tsshendo/PFC-Implementation--Senior-Design-Project/Schematic PDF.pdf

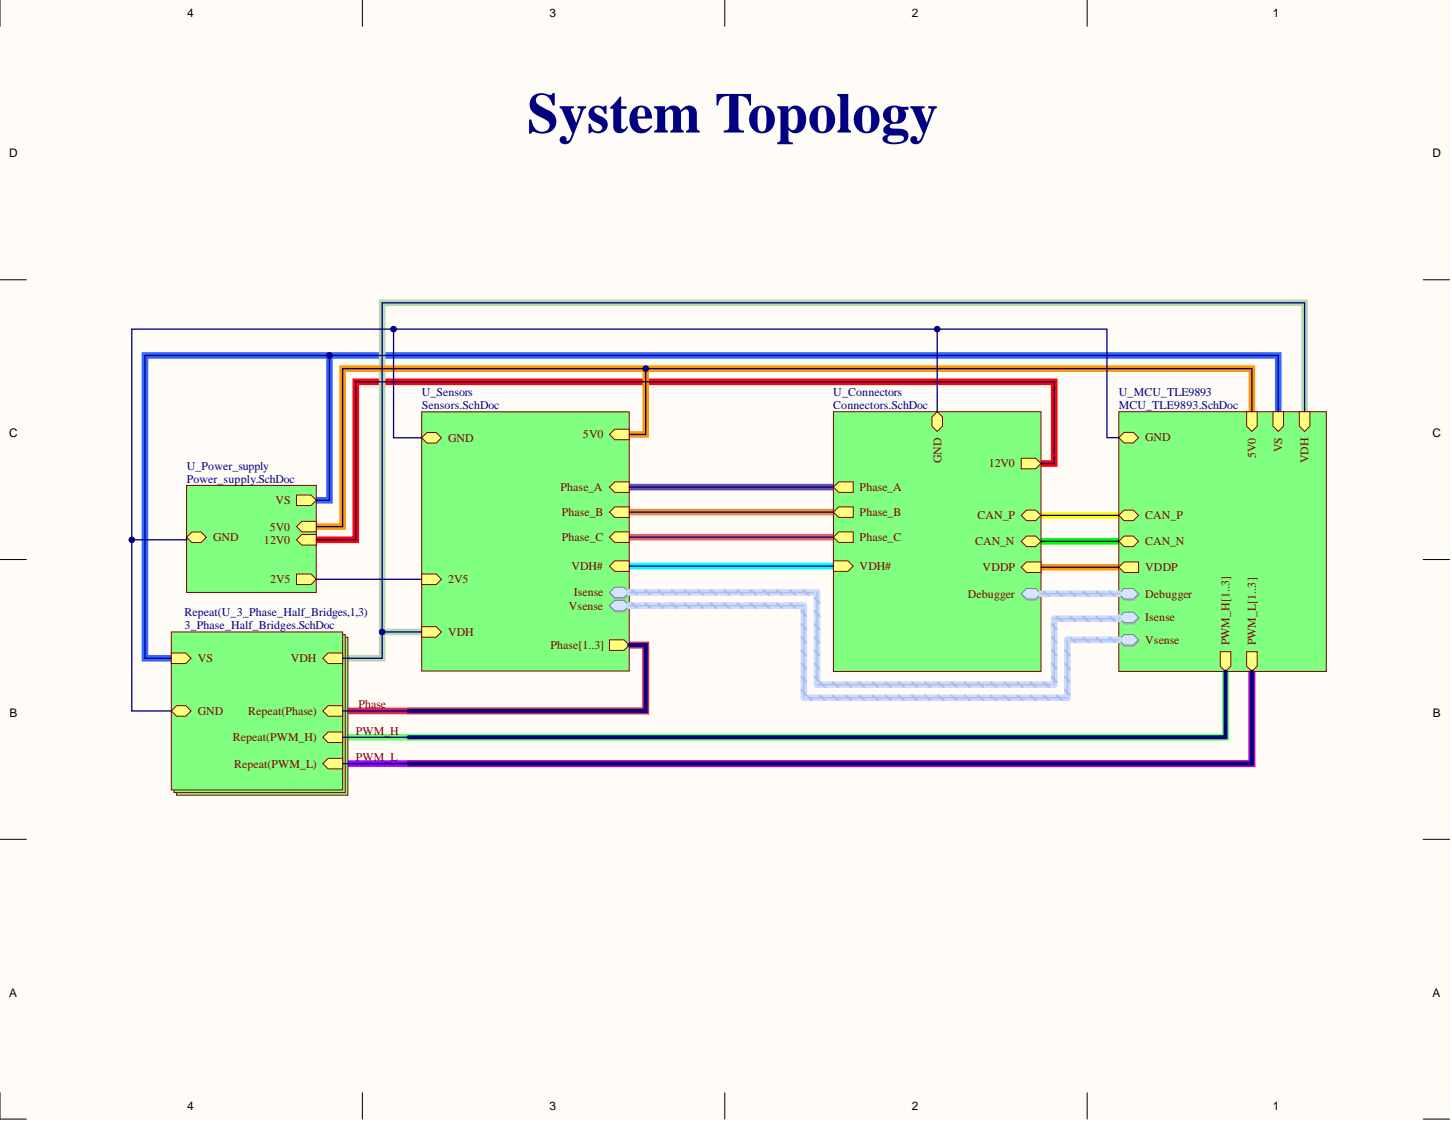
[picture p1: page 1]
System Topology

U_Sensors Sensors.SchDoc | U_Connectors Connectors.SchDoc

U_MCU_TLE9893 MCU_TLE9893.SchDoc

5V0 GND Phase_A | 12V0 Phase_A | | | GND VS

Phase_B Phase_C VDH# 2V5 Isense Vsense VDH | | Phase_B CAN_P Phase_C CAN_N VDH# VDDP Debugger | CAN_P CAN_N VDDP Debugger Isense

Phase[1..3] | | Vsense

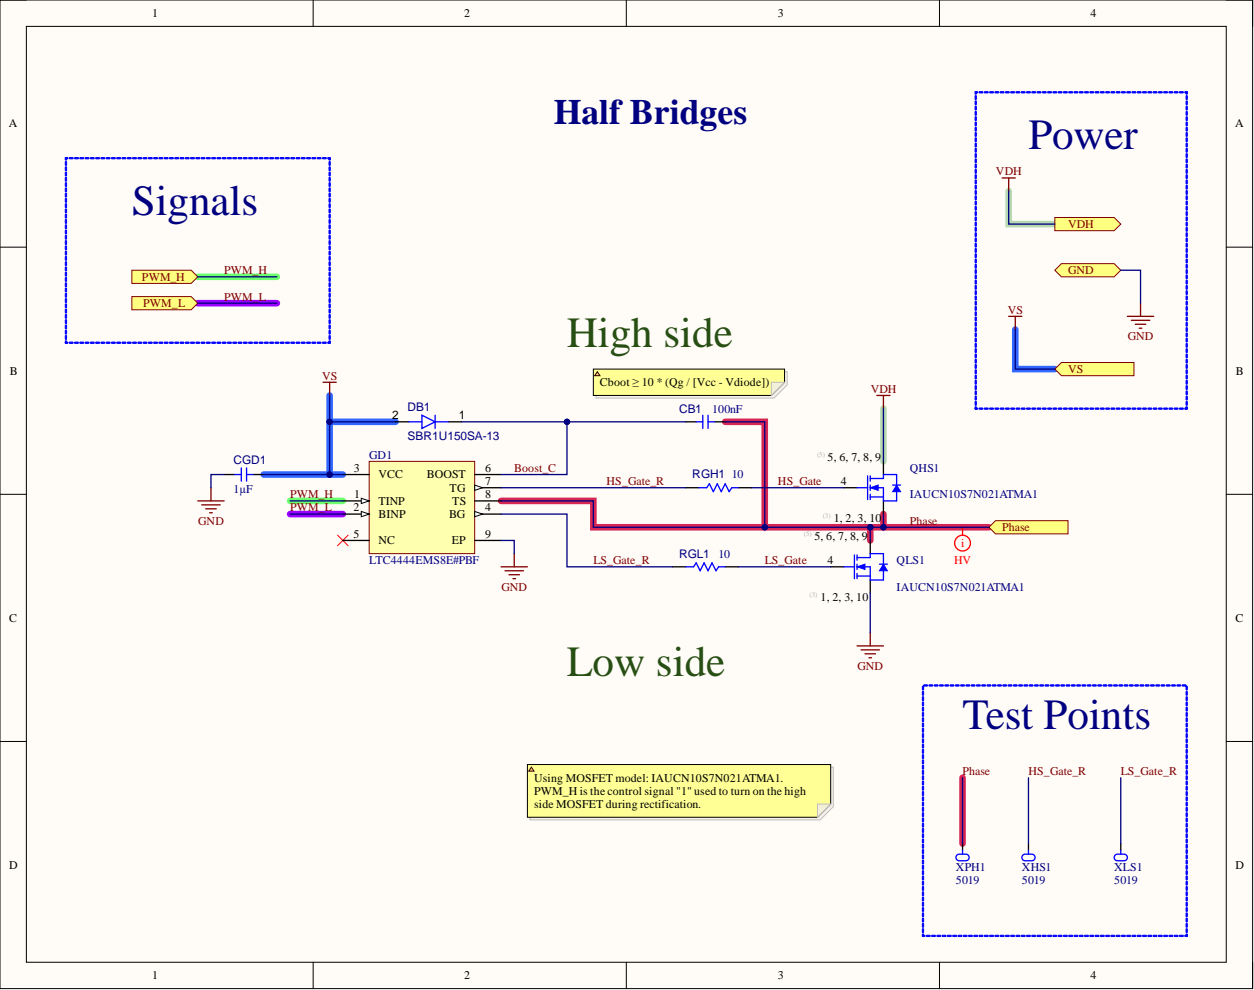
[picture p2: page 2]
Half Bridges; High side; Low side; Test Points; TINP 1 BINP 2; VCC 3; RGL1 10

Cboot ≥ 10 * (Qg / [Vcc - Vdiode])

Using MOSFET model: IAUCN10S7N021ATMA1.
PWM_H is the control signal "1" used to turn on the high
side MOSFET during rectification.

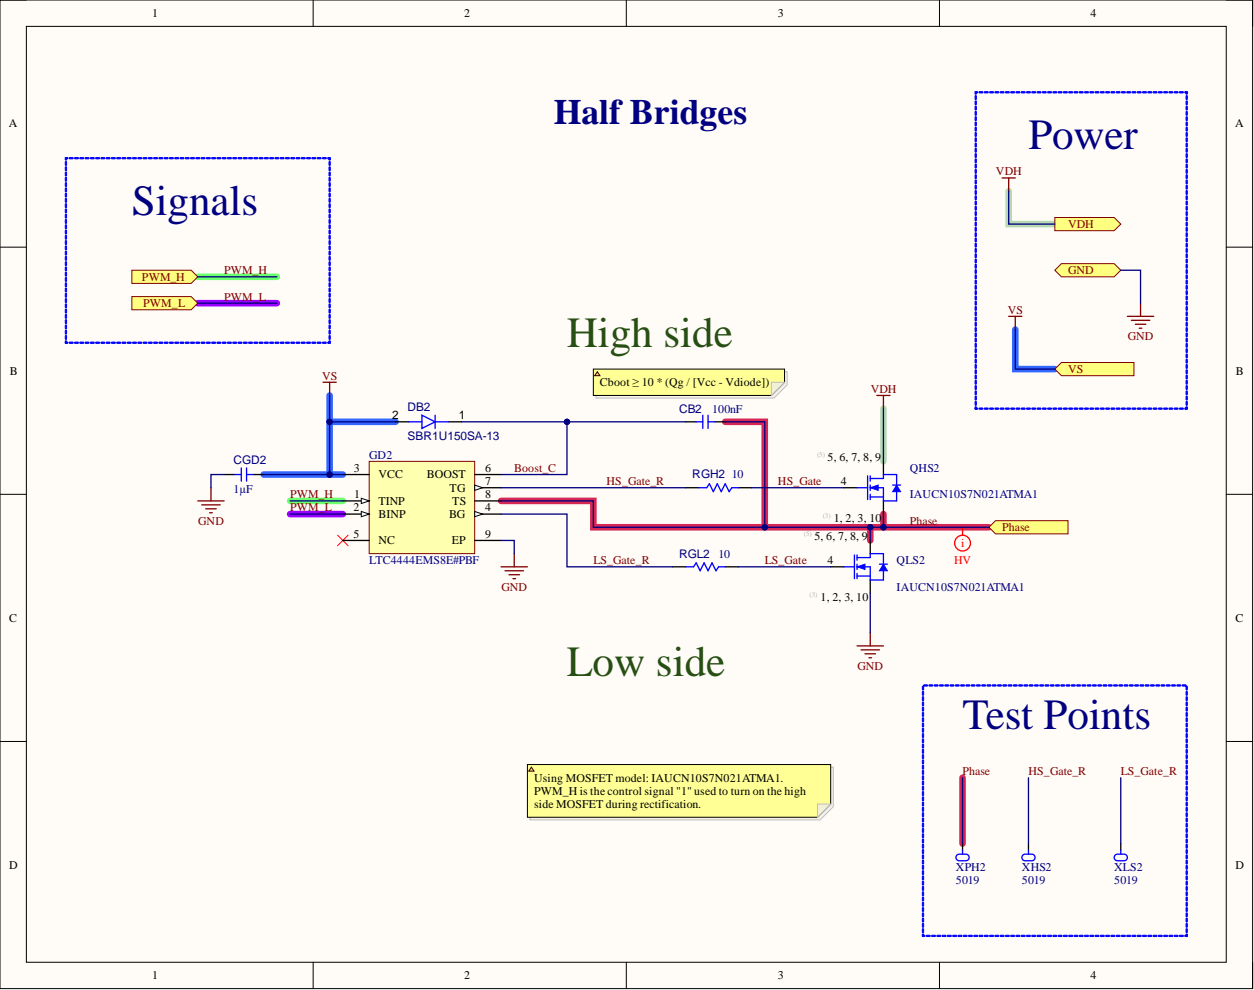
[picture p3: page 3]
Half Bridges; High side; Low side; Test Points; TINP 1 BINP 2; VCC 3; RGL2 10

Cboot ≥ 10 * (Qg / [Vcc - Vdiode])

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

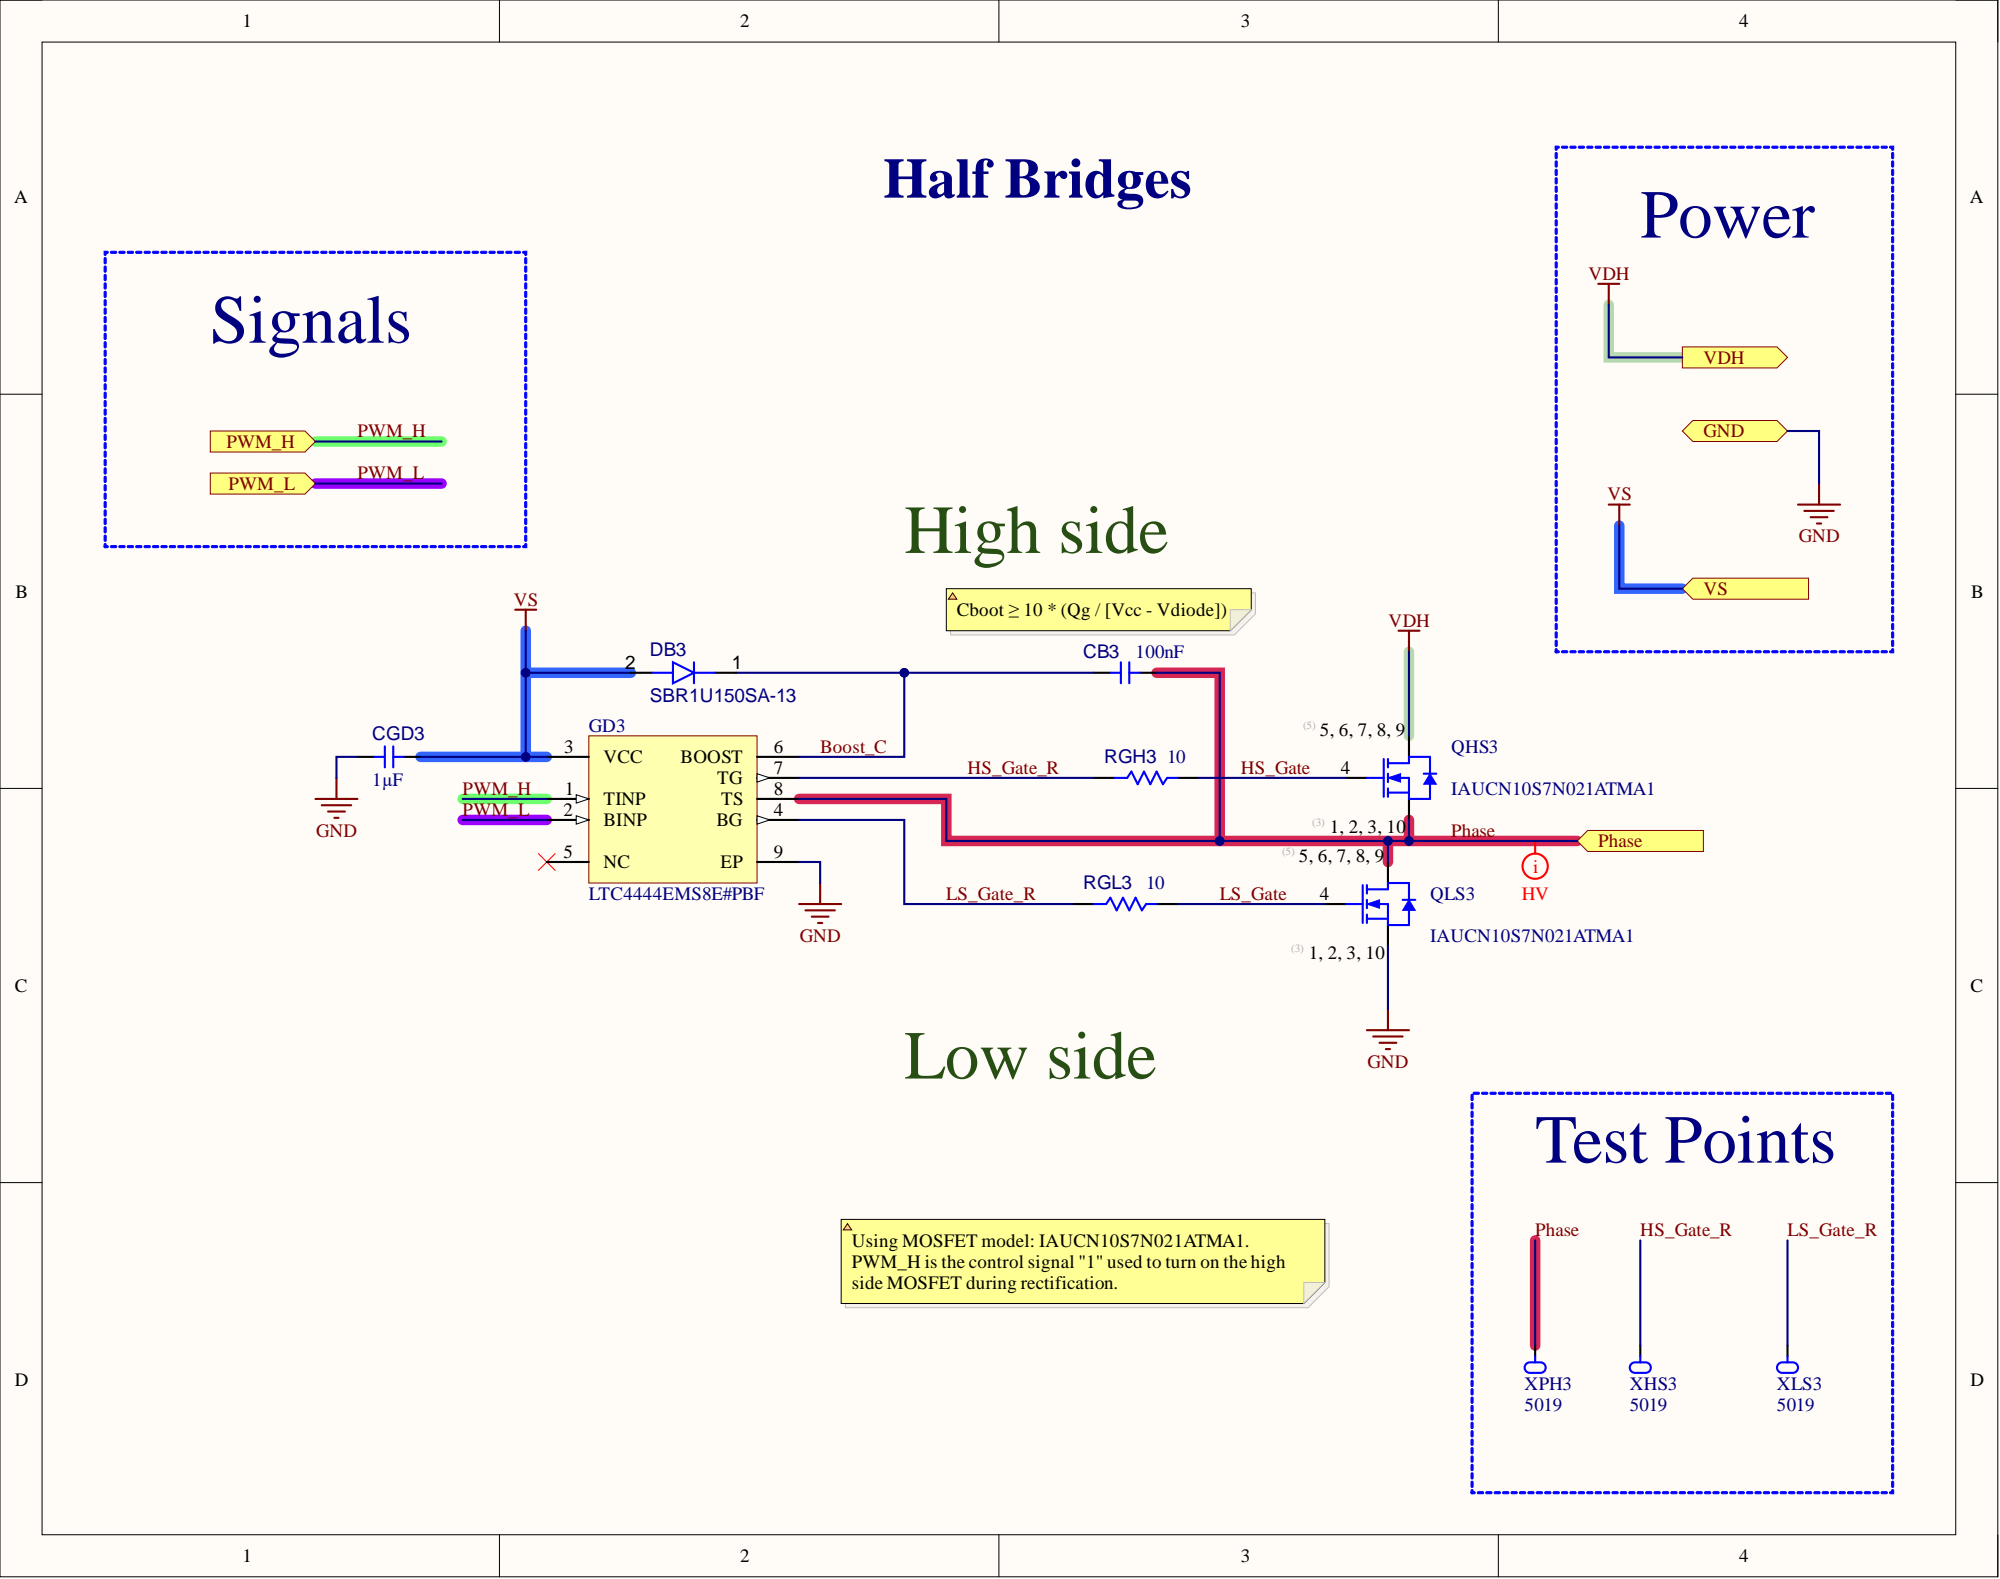
[picture p4: page 4]
Half Bridges; High side; Low side; Test Points; TINP 1 BINP 2; VCC 3; RGL3 10; PIGD306; NLBoost0C PICGD301; PIRGH302; PIQHS304 NLHS0Gate PIGD307; PIRGH301; NLPWM0H POPWM0H; NLPWM0L POPWM0L

Cboot ≥ 10 * (Qg / [Vcc - Vdiode])

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

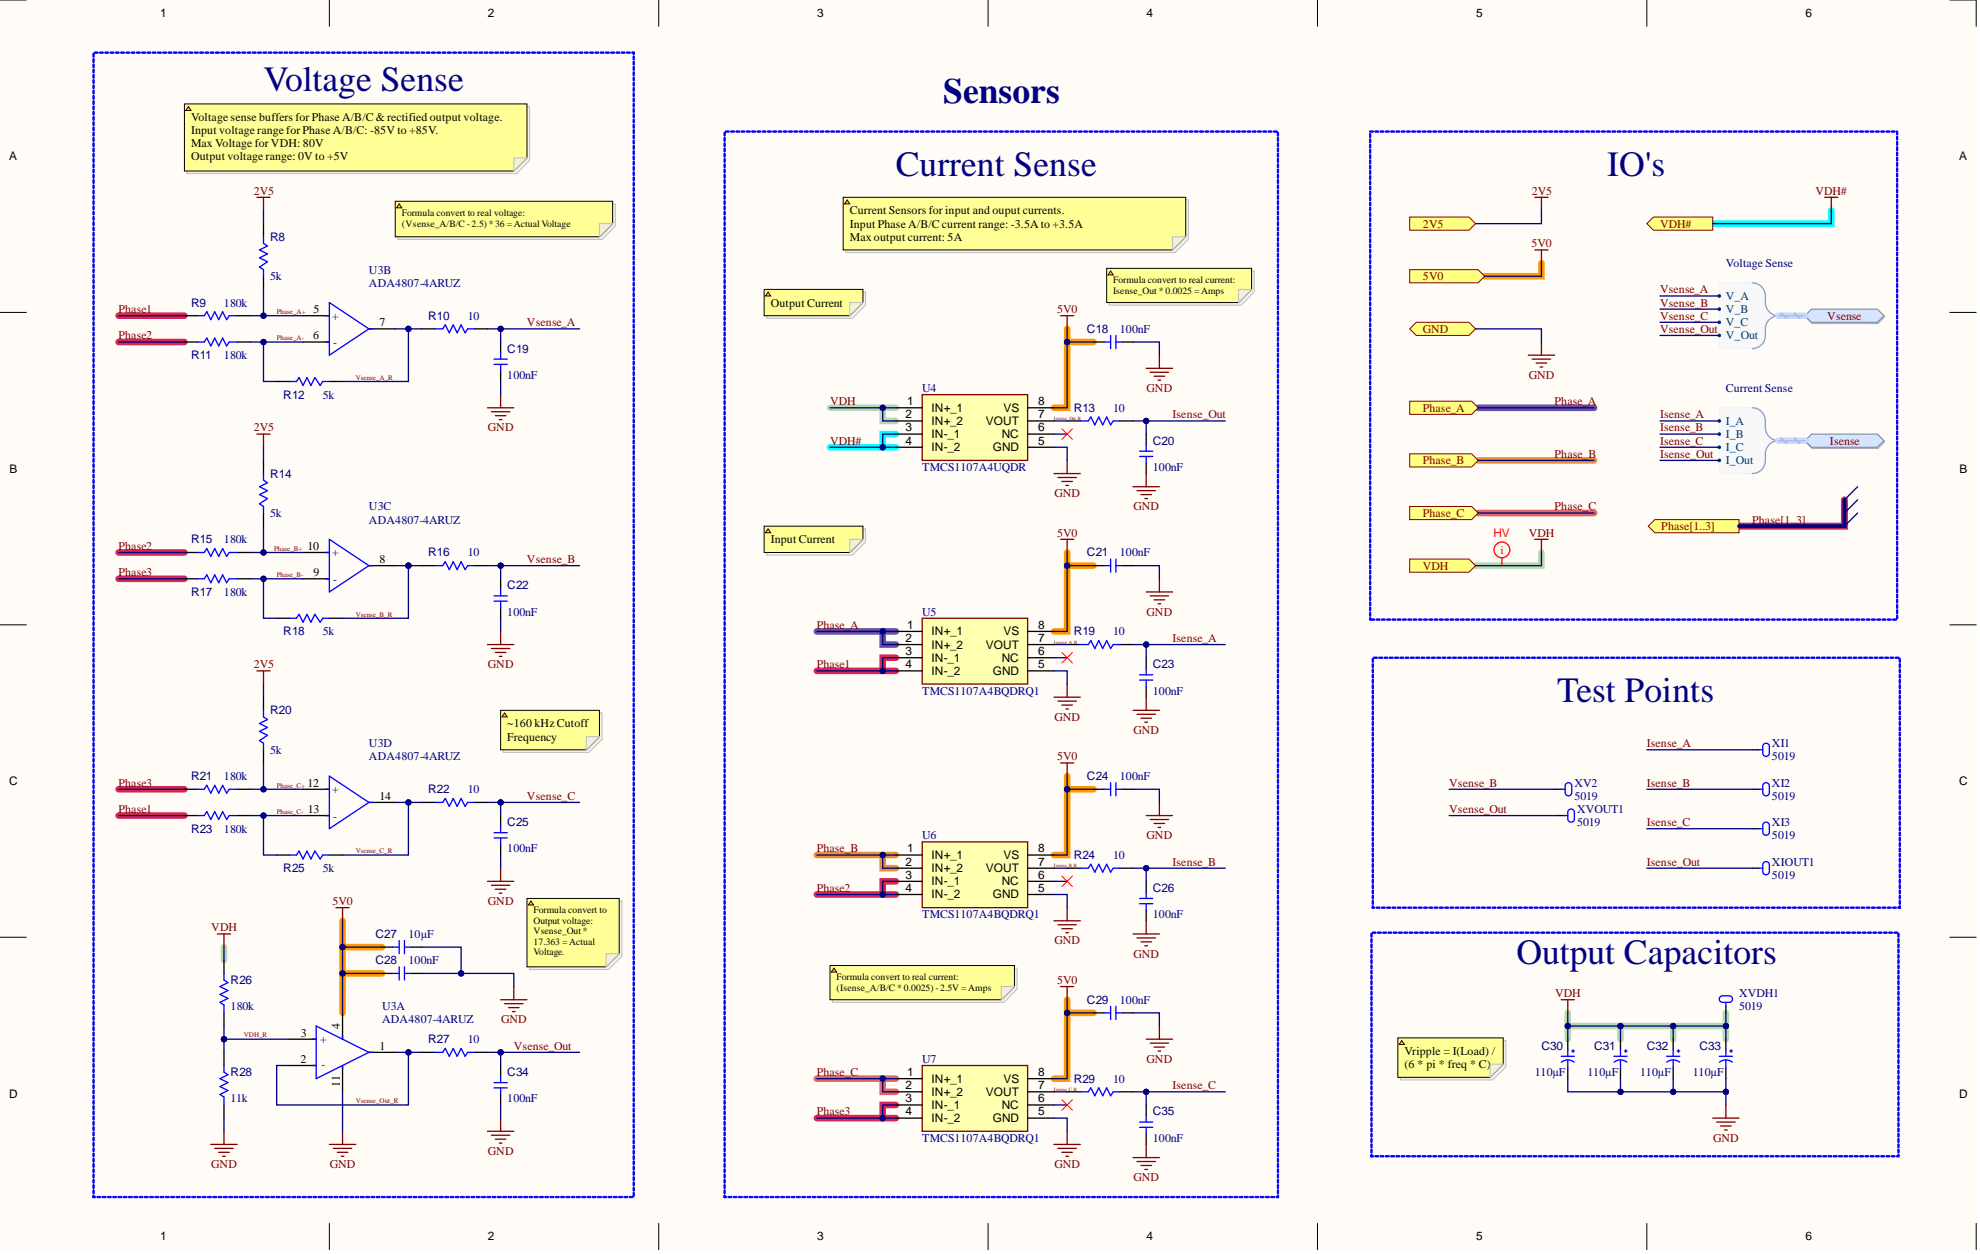
[picture p5: page 5]
s oltage Sense; Current Sense; 2V5 5V0 5V0 GND; t Sen; Test Points; tage Sen; Output Capacitors XVDH1 5019; uffersfor Phase; /B/C & rect; tage ran; ge for Phase; tage for tage ran; ors for; t curren; t Phase; /B/C curren; t ran; t Curre; = Amps; rt to e_Out * 0.0025; i * freq * C); t Curren; al voltage: - 2.5) * 36; = Actual; rt to Output voltage: e_Out * = Actual

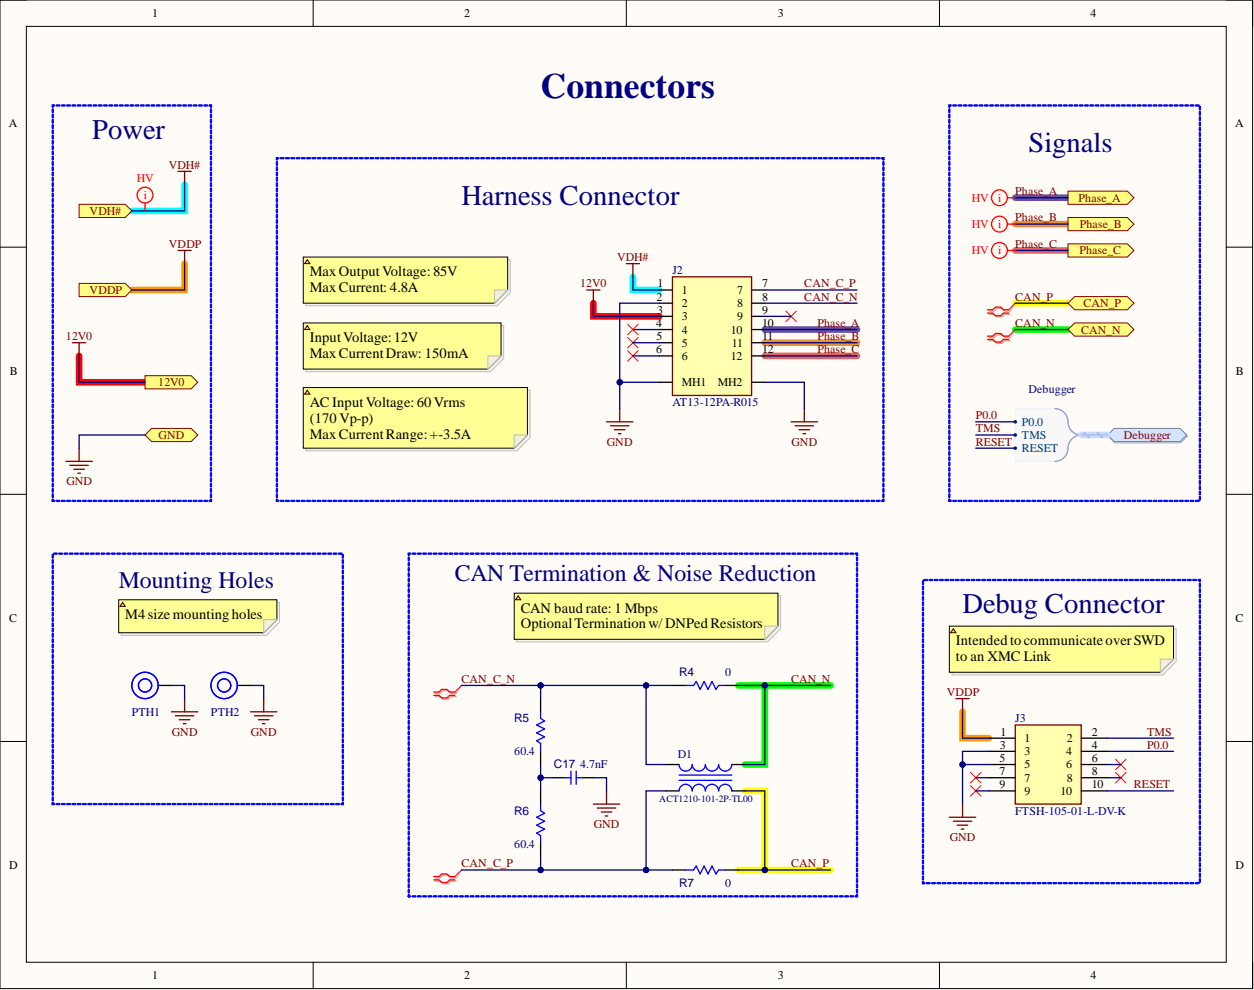
[picture p6: page 6]

3 3
4 4

AC Input Voltage: 60 Vrms
MaxCurrent Range: +-3.5A

CAN Termination & Noise Reduction

CAN baud rate: 1 Mbps
Optional Termination w/ DNPedResistors

Intended to communicate over SWD
to an XMC Link

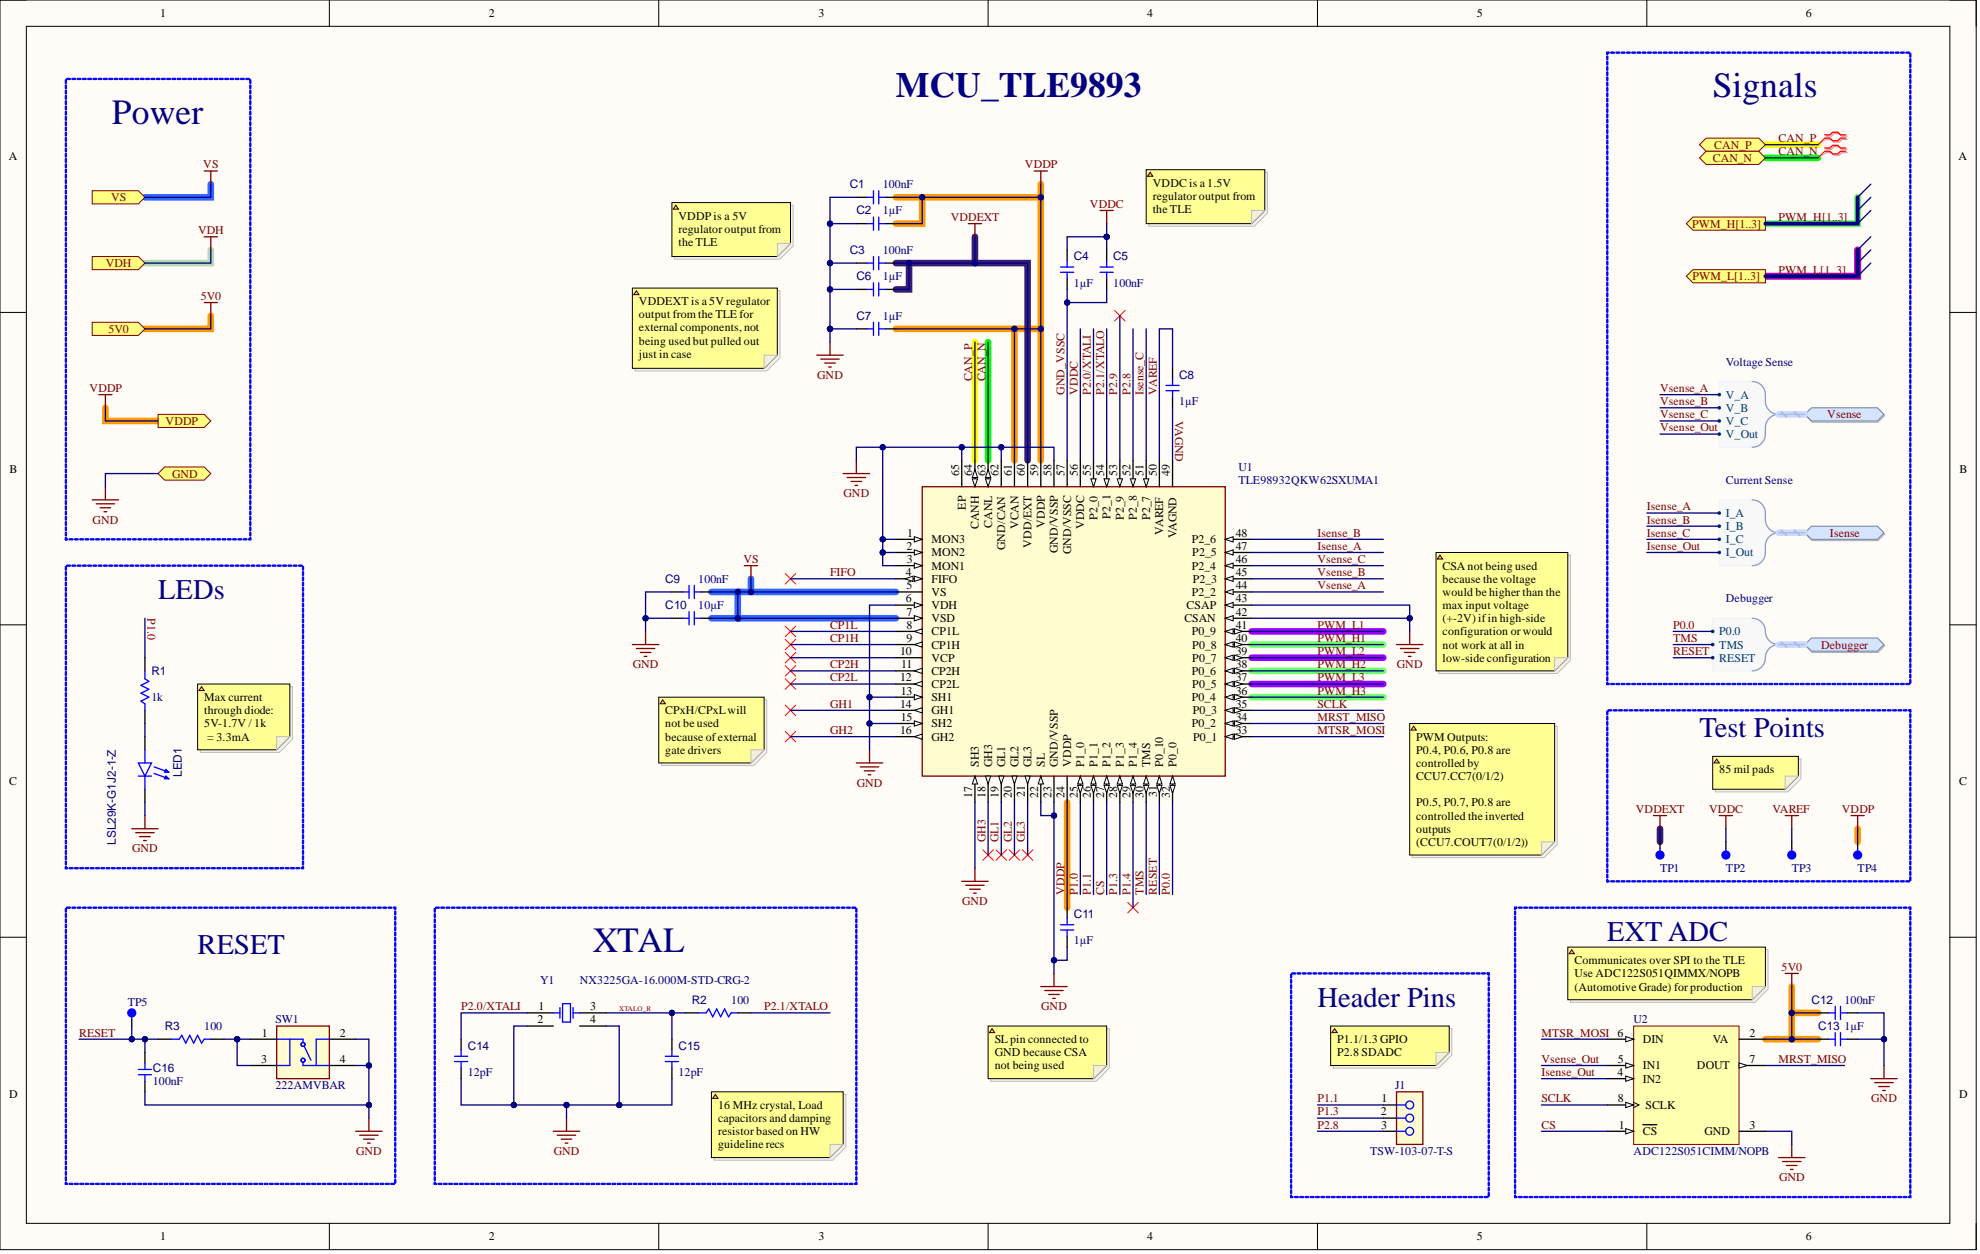
[picture p7: page 7]

VDDEXT is a 5V regulator
output from the TLE for
external components, not
being used but pulled out
just in case

VAGND 49 VAREF 50 P2_7 51 P2_8 52 P2_9 53 P2_1 54 P2_0 55 VDDC 56 GND/VSSC 57 GND/VSSP 58 VDDP 59 VDD/EXT 60 VCAN 61 GND/CAN 62 CANL 63 CANH 64 EP 65

MON2 2
MON1 3

CSA not being used
because the voltage
would be higher than the
max input voltage
(+-2V) if in high-side
configuration or would
not work at all in
low-side configuration

VSD 7 CP1L 8 CP1H 9 VCP 10 CP2H 11 CP2L 12 SH1 13

Communicates over SPI to the TLE
Use ADC122S051QIMMX/NOPB
(Automotive Grade) for production

SL pin connected to
GND because CSA
not being used

16 MHz crystal, Load
capacitors and damping
resistor based on HW
guideline recs

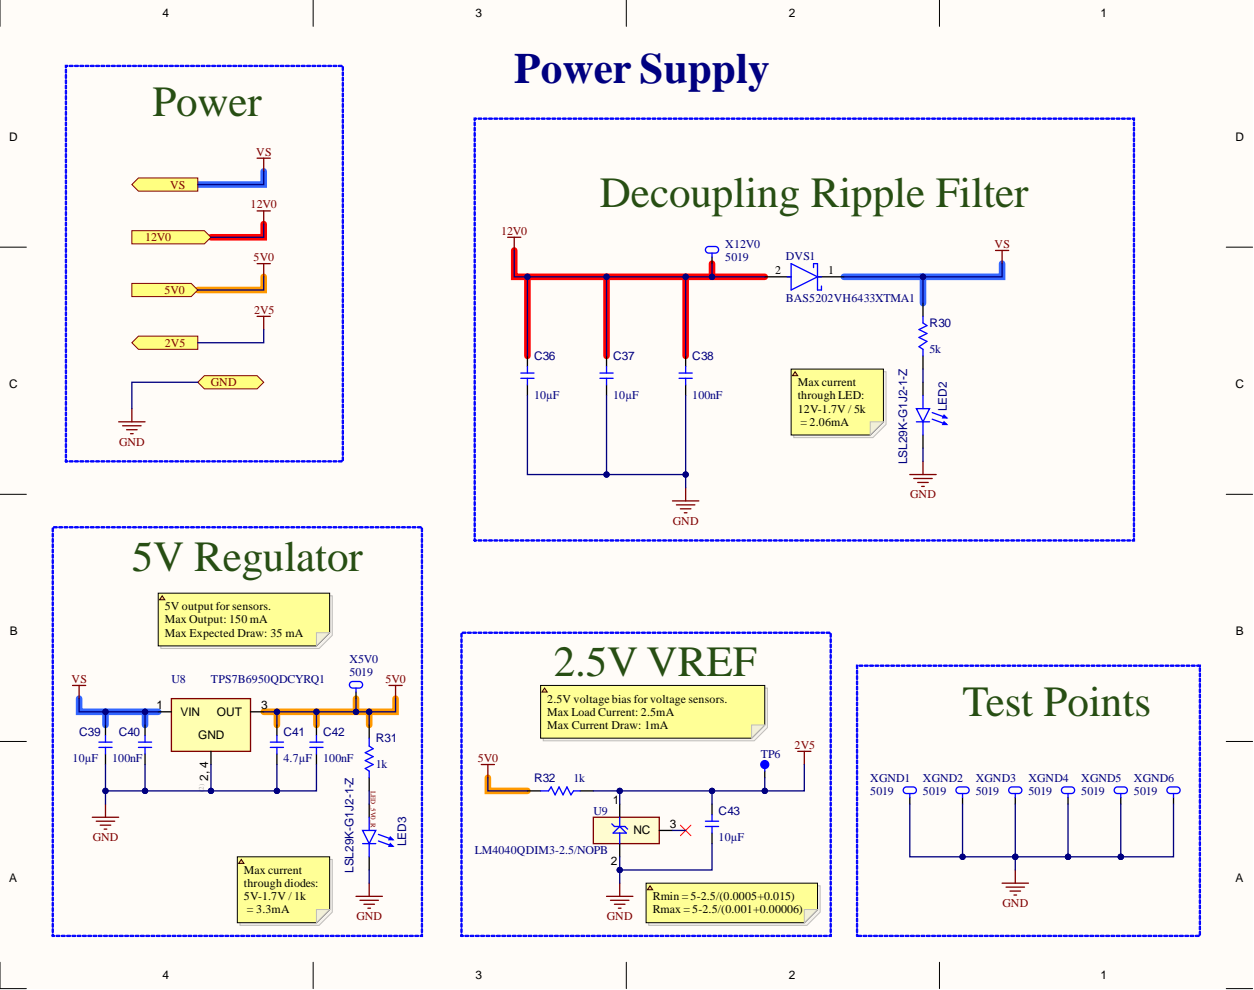
[picture p8: page 8]

5V output for sensors.
Max Output: 150 mA
Max Expected Draw: 35 mA

2.5V voltage bias for voltage sensors.
Max Load Current: 2.5mA
Max Current Draw: 1mA
